Vishnu9247/Remote-Mobile-Robot--Mapping-Localization-and-Navigation/CAD Files/robot_redesign_R1/docs/wheel_module_exploded.png

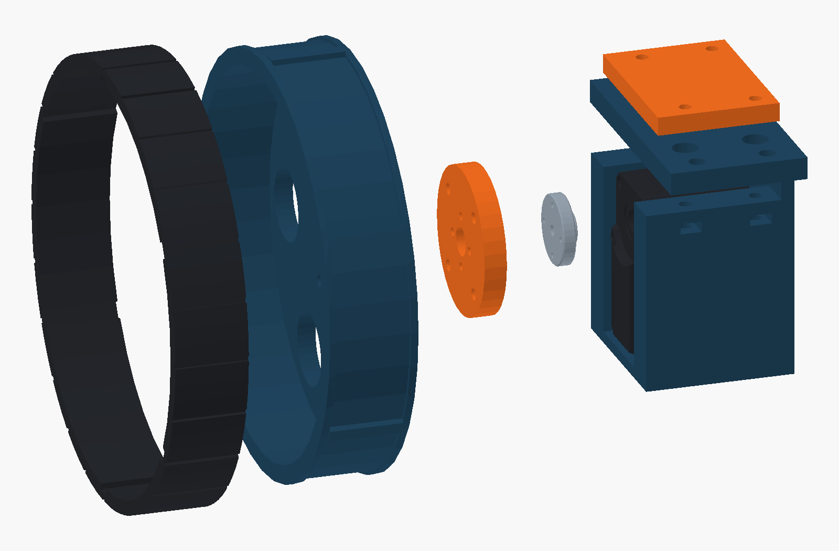
CAD Files/robot_redesign_R1/docs/wheel_module_exploded.png
