Vishnu9247/Remote-Mobile-Robot--Mapping-Localization-and-Navigation/CAD Files/robot_redesign_R1/reference/horn_brackets_vendor.stp

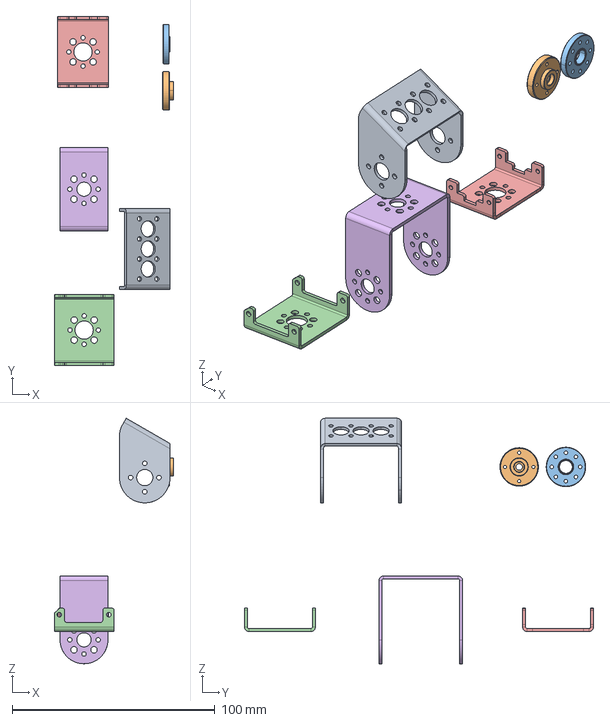
[picture p3: CAD file, 2026-10-05]
CAD Files/robot_redesign_R1/reference/horn_brackets_vendor.stp
59.0 x 172.3 x 121.2 mm
