Vishnu9247/Remote-Mobile-Robot--Mapping-Localization-and-Navigation/CAD Files/robot_redesign_R1/STEP/P07_horn_adapter.step

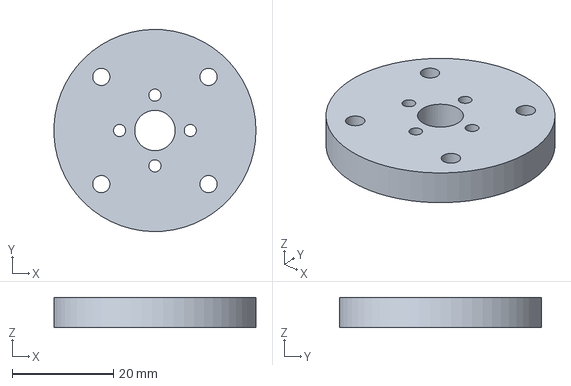
[picture p4: CAD file, 2026-10-05]
CAD Files/robot_redesign_R1/STEP/P07_horn_adapter.step
40.0 x 40.0 x 6.00 mm
