Vishnu9247/Remote-Mobile-Robot--Mapping-Localization-and-Navigation/mobile_robot_ws/src/mobile_robot_description/meshes/P10_sensor_platform.stl

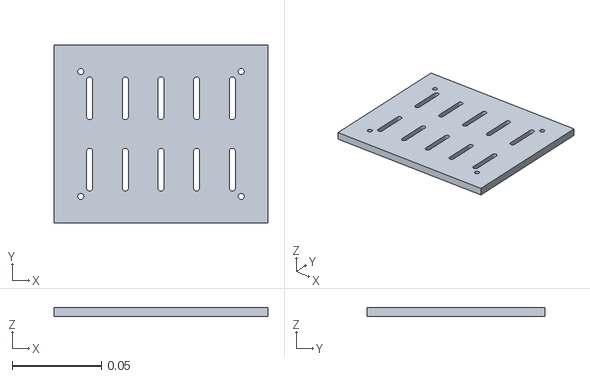
[picture p5: CAD file, 2026-10-05]
mobile_robot_ws/src/mobile_robot_description/meshes/P10_sensor_platform.stl
0.12 x 0.1 x 0.005
