Vishnu9247/Remote-Mobile-Robot--Mapping-Localization-and-Navigation/CAD Files/robot_redesign_R1/reference/HX30HM_vendor.stp

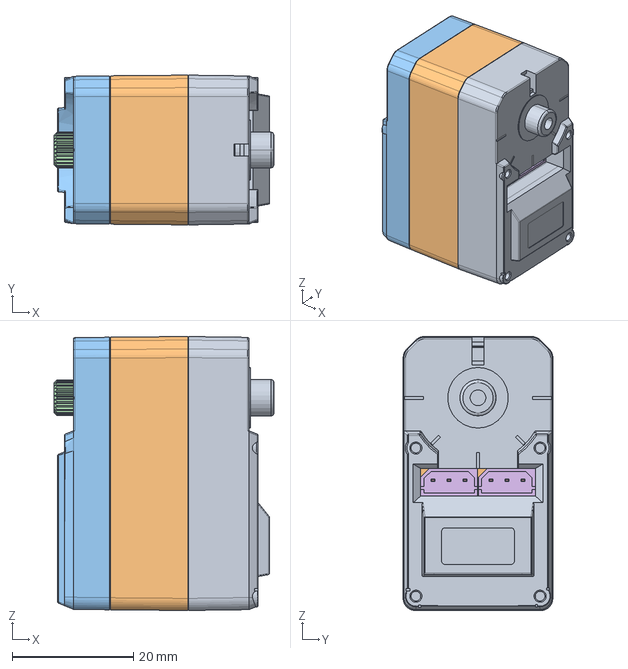
[picture p6: CAD file, 2026-10-05]
CAD Files/robot_redesign_R1/reference/HX30HM_vendor.stp
36.3 x 24.7 x 45.2 mm
