Vishnu9247/Remote-Mobile-Robot--Mapping-Localization-and-Navigation/CAD Files/robot_redesign_R1/STEP/P01_deck_front.step

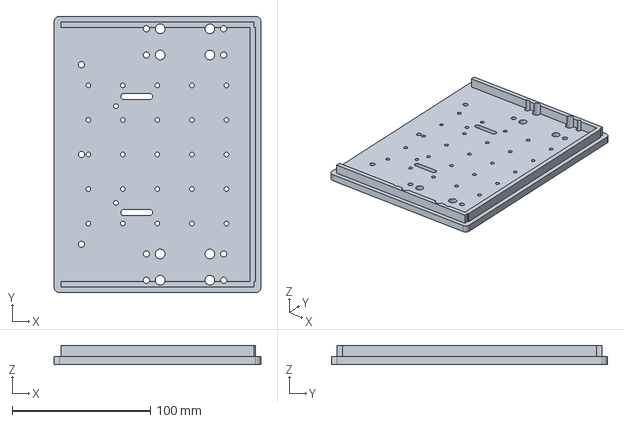
[picture p7: CAD file, 2026-10-05]
CAD Files/robot_redesign_R1/STEP/P01_deck_front.step
149.8 x 200.0 x 14.0 mm
