Vishnu9247/Remote-Mobile-Robot--Mapping-Localization-and-Navigation/mobile_robot_ws/src/mobile_robot_description/meshes/P08_wheel_rim.stl

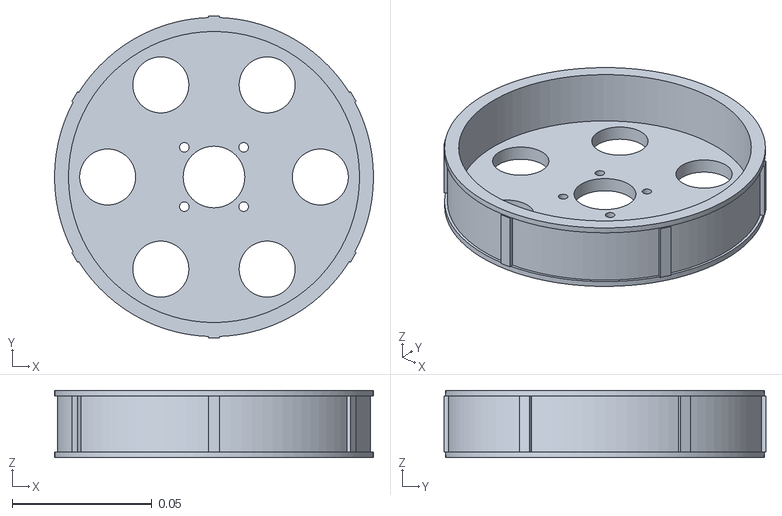
[picture p8: CAD file, 2026-10-05]
mobile_robot_ws/src/mobile_robot_description/meshes/P08_wheel_rim.stl
0.114 x 0.115 x 0.024
