Vishnu9247/Remote-Mobile-Robot--Mapping-Localization-and-Navigation/CAD Files/robot_redesign_R1/STEP/HX30HM_drive_horn_reference.step

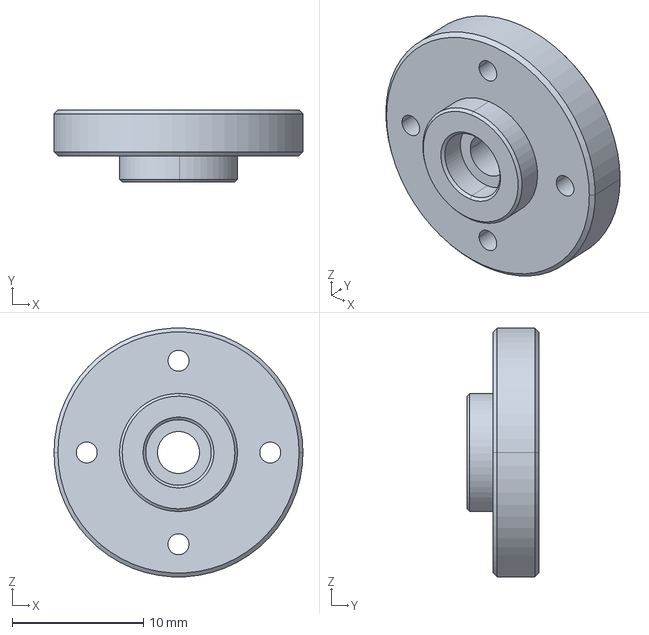
[picture p9: CAD file, 2026-10-05]
CAD Files/robot_redesign_R1/STEP/HX30HM_drive_horn_reference.step
19.0 x 5.50 x 19.0 mm
