Vishnu9247/Remote-Mobile-Robot--Mapping-Localization-and-Navigation/mobile_robot_ws/src/mobile_robot_description/meshes/P02_deck_rear.stl

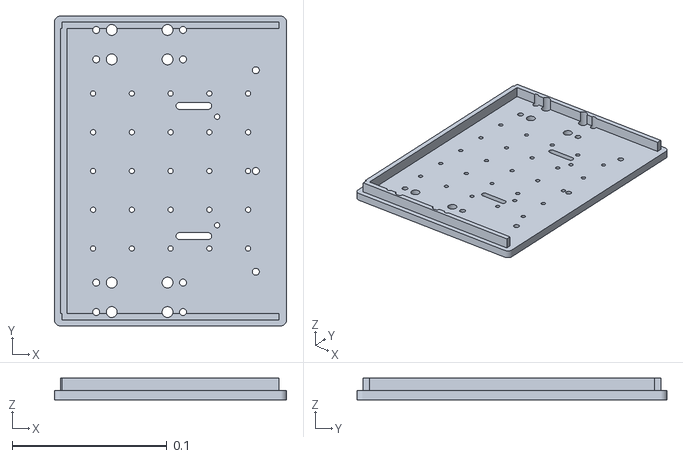
[picture p10: CAD file, 2026-10-05]
mobile_robot_ws/src/mobile_robot_description/meshes/P02_deck_rear.stl
0.15 x 0.2 x 0.014
