Vishnu9247/Remote-Mobile-Robot--Mapping-Localization-and-Navigation/CAD Files/robot_redesign_R1/STEP/P10_sensor_platform.step

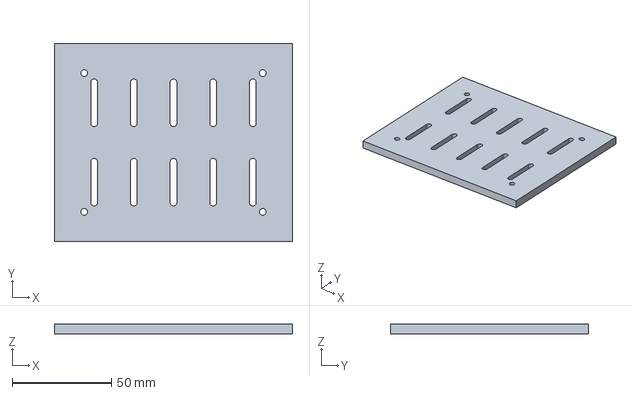
[picture p11: CAD file, 2026-10-05]
CAD Files/robot_redesign_R1/STEP/P10_sensor_platform.step
120.0 x 100.0 x 5.00 mm
