Vishnu9247/Remote-Mobile-Robot--Mapping-Localization-and-Navigation/CAD Files/robot_redesign_R1/STEP/P11_platform_spacer.step

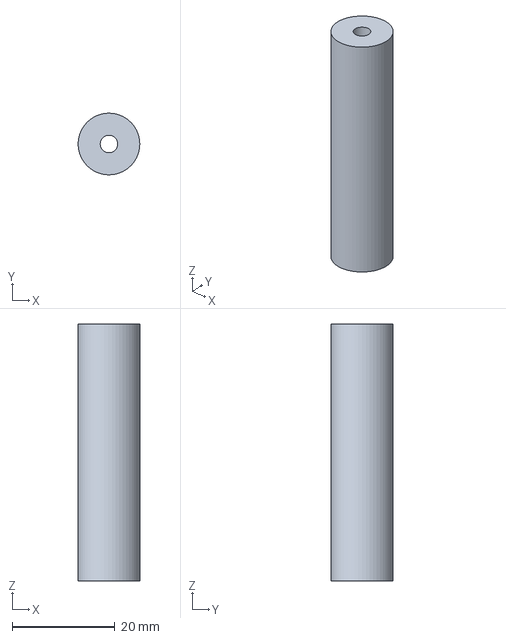
[picture p12: CAD file, 2026-10-05]
CAD Files/robot_redesign_R1/STEP/P11_platform_spacer.step
12.0 x 12.0 x 50.0 mm
