Vishnu9247/Remote-Mobile-Robot--Mapping-Localization-and-Navigation/mobile_robot_ws/src/mobile_robot_description/meshes/P09_TPU_tyre.stl

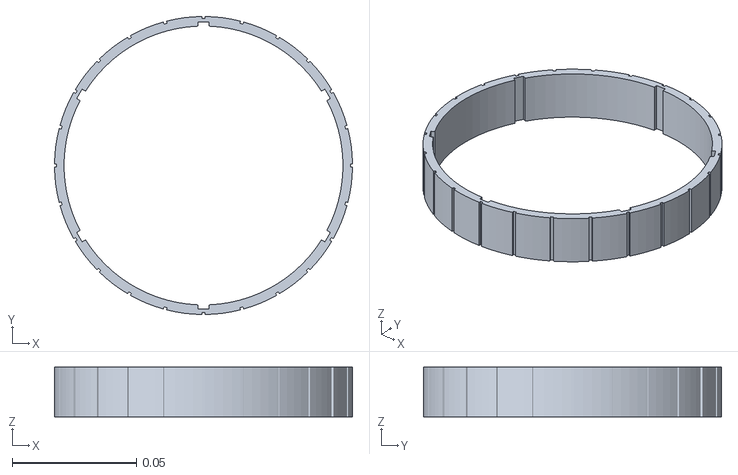
[picture p13: CAD file, 2026-10-05]
mobile_robot_ws/src/mobile_robot_description/meshes/P09_TPU_tyre.stl
0.12 x 0.12 x 0.02
