Vishnu9247/Remote-Mobile-Robot--Mapping-Localization-and-Navigation/CAD Files/robot_redesign_R1/STEP/P04_servo_clamp_cap.step

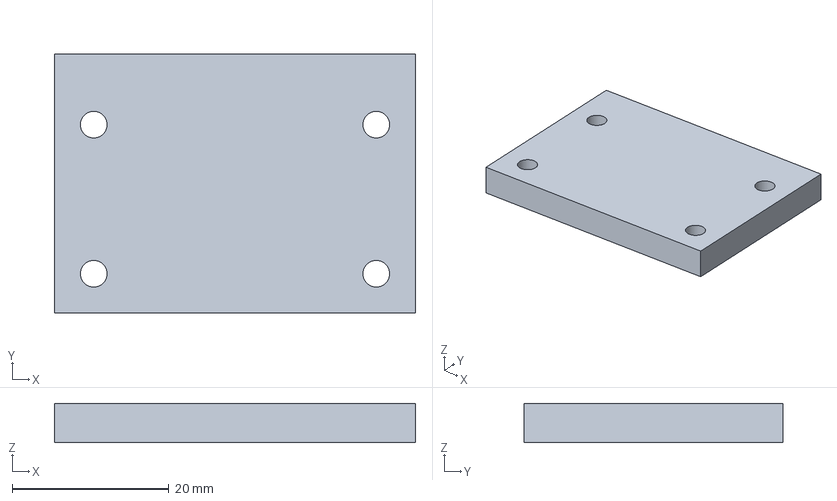
[picture p14: CAD file, 2026-10-05]
CAD Files/robot_redesign_R1/STEP/P04_servo_clamp_cap.step
46.0 x 33.0 x 5.00 mm
