Vishnu9247/Remote-Mobile-Robot--Mapping-Localization-and-Navigation/CAD Files/robot_redesign_R1/STEP/HARDWARE_nominal_fasteners.step

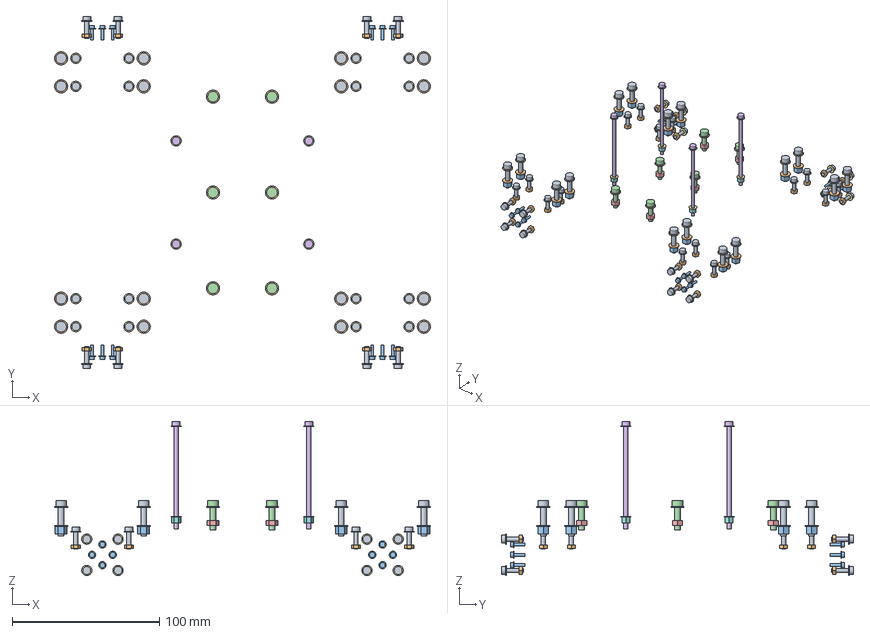
[picture p15: CAD file, 2026-10-05]
CAD Files/robot_redesign_R1/STEP/HARDWARE_nominal_fasteners.step
255.0 x 239.0 x 104.6 mm
cradle_0_bolt
cradle_0_top_washer
cradle_0_bottom_washer
cradle_0_nyloc
cradle_1_bolt
cradle_1_top_washer
cradle_1_bottom_washer
cradle_1_nyloc
cradle_2_bolt
cradle_2_top_washer
cradle_2_bottom_washer
cradle_2_nyloc
cradle_3_bolt
cradle_3_top_washer
cradle_3_bottom_washer
cradle_3_nyloc
cradle_4_bolt
cradle_4_top_washer
cradle_4_bottom_washer
cradle_4_nyloc
cradle_5_bolt
cradle_5_top_washer
cradle_5_bottom_washer
cradle_5_nyloc
cradle_6_bolt
cradle_6_top_washer
cradle_6_bottom_washer
cradle_6_nyloc
cradle_7_bolt
cradle_7_top_washer
cradle_7_bottom_washer
cradle_7_nyloc
cradle_8_bolt
cradle_8_top_washer
cradle_8_bottom_washer
cradle_8_nyloc
cradle_9_bolt
cradle_9_top_washer
cradle_9_bottom_washer
cradle_9_nyloc
cradle_10_bolt
cradle_10_top_washer
cradle_10_bottom_washer
cradle_10_nyloc
cradle_11_bolt
cradle_11_top_washer
cradle_11_bottom_washer
cradle_11_nyloc
cradle_12_bolt
cradle_12_top_washer
cradle_12_bottom_washer
cradle_12_nyloc
cradle_13_bolt
cradle_13_top_washer
cradle_13_bottom_washer
cradle_13_nyloc
cradle_14_bolt
cradle_14_top_washer
cradle_14_bottom_washer
cradle_14_nyloc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
