Vishnu9247/Remote-Mobile-Robot--Mapping-Localization-and-Navigation/CAD Files/robot_redesign_R1/STEP/P09_TPU_tyre.step

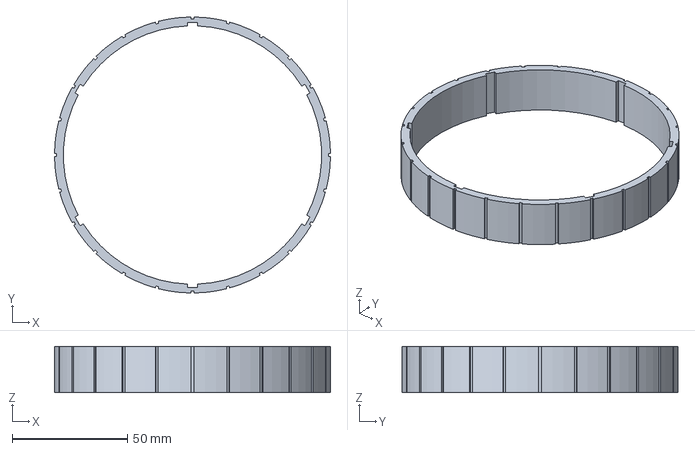
[picture p16: CAD file, 2026-10-05]
CAD Files/robot_redesign_R1/STEP/P09_TPU_tyre.step
120.0 x 120.0 x 20.0 mm
