Vishnu9247/Remote-Mobile-Robot--Mapping-Localization-and-Navigation/CAD Files/robot_redesign_R1/STEP/P03_servo_cradle.step

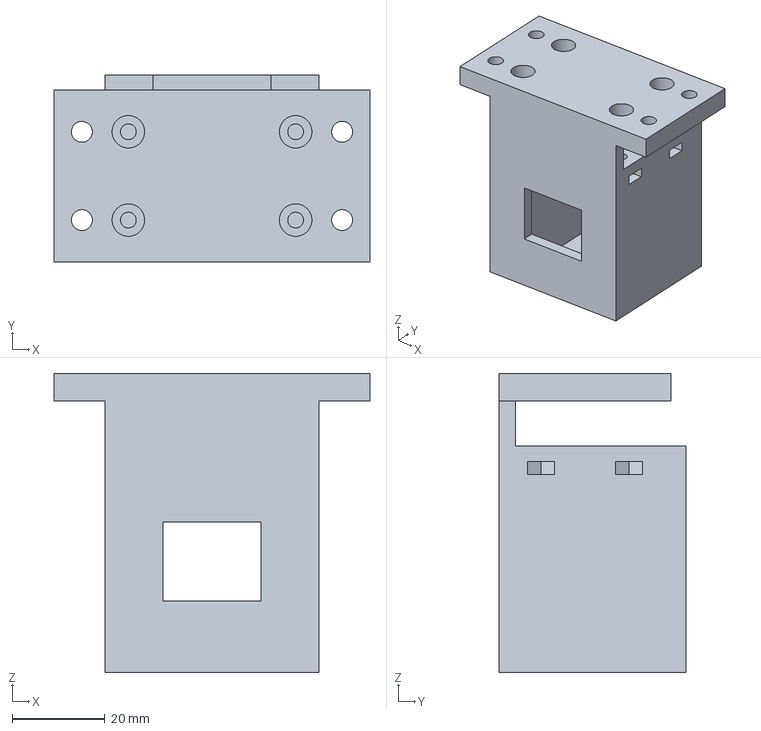
[picture p17: CAD file, 2026-10-05]
CAD Files/robot_redesign_R1/STEP/P03_servo_cradle.step
68.0 x 40.2 x 64.4 mm
