Vishnu9247/Remote-Mobile-Robot--Mapping-Localization-and-Navigation/CAD Files/robot_redesign_R1/STEP/P08_wheel_rim.step

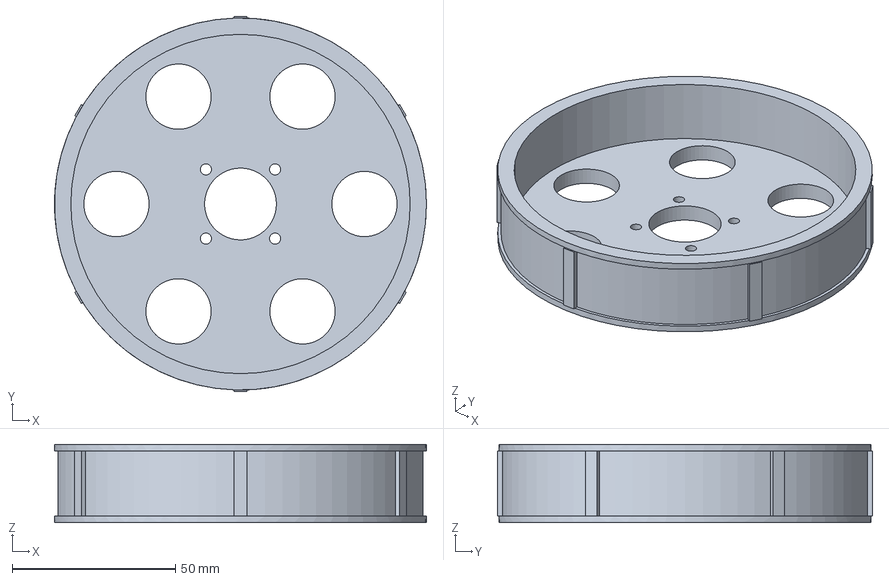
[picture p18: CAD file, 2026-10-05]
CAD Files/robot_redesign_R1/STEP/P08_wheel_rim.step
114.0 x 115.0 x 24.0 mm
