Vishnu9247/Remote-Mobile-Robot--Mapping-Localization-and-Navigation/CAD Files/robot_redesign_R1/STEP/P05_servo_shim.step

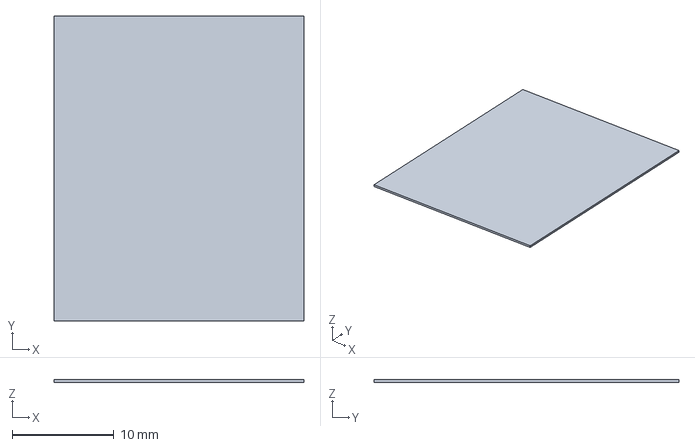
[picture p19: CAD file, 2026-10-05]
CAD Files/robot_redesign_R1/STEP/P05_servo_shim.step
24.6 x 30.0 x 0.25 mm
