Vishnu9247/Remote-Mobile-Robot--Mapping-Localization-and-Navigation/CAD Files/robot_redesign_R1/STEP/P06_chassis_splice.step

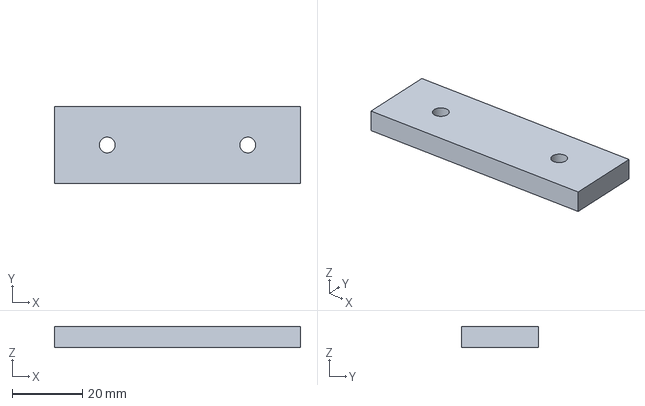
[picture p20: CAD file, 2026-10-05]
CAD Files/robot_redesign_R1/STEP/P06_chassis_splice.step
70.0 x 22.0 x 6.00 mm
