Vishnu9247/Remote-Mobile-Robot--Mapping-Localization-and-Navigation/CAD Files/robot_redesign_R1/STEP/P12_fastener_fit_coupon.step

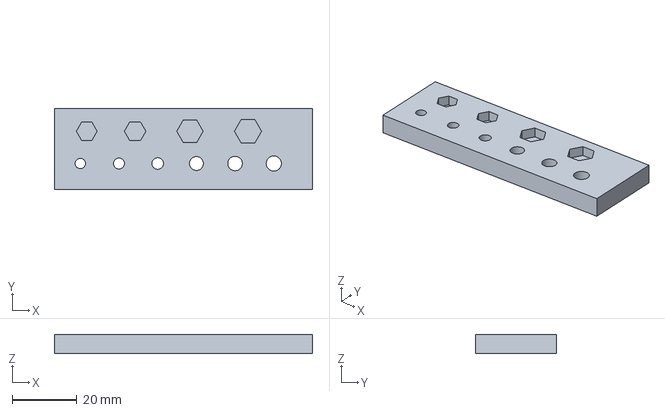
[picture p21: CAD file, 2026-10-05]
CAD Files/robot_redesign_R1/STEP/P12_fastener_fit_coupon.step
80.0 x 25.0 x 6.00 mm
