Vishnu9247/Remote-Mobile-Robot--Mapping-Localization-and-Navigation/(list of files, cad)

Other CAD files:
mobile_robot_ws/src/mobile_robot_description/meshes/P01_deck_front.stl
CAD Files/robot_redesign_R1/STEP/P02_deck_rear.step
CAD Files/robot_redesign_R1/STEP/HX30HM_manufacturer_reference.step
CAD Files/robot_redesign_R1/STL/P01_deck_front.stl
CAD Files/robot_redesign_R1/STL/P02_deck_rear.stl
CAD Files/robot_redesign_R1/STL/P03_servo_cradle.stl
CAD Files/robot_redesign_R1/STL/P04_servo_clamp_cap.stl
CAD Files/robot_redesign_R1/STL/P05_servo_shim.stl
CAD Files/robot_redesign_R1/STL/P06_chassis_splice.stl
CAD Files/robot_redesign_R1/STL/P07_horn_adapter.stl
CAD Files/robot_redesign_R1/STL/P08_wheel_rim.stl
CAD Files/robot_redesign_R1/STL/P09_TPU_tyre.stl
CAD Files/robot_redesign_R1/STL/P10_sensor_platform.stl
CAD Files/robot_redesign_R1/STL/P11_platform_spacer.stl
CAD Files/robot_redesign_R1/STL/P12_fastener_fit_coupon.stl
